shchuko/Automation-system/circuits/actuators_module/Схема модуля исполнителей.JPG

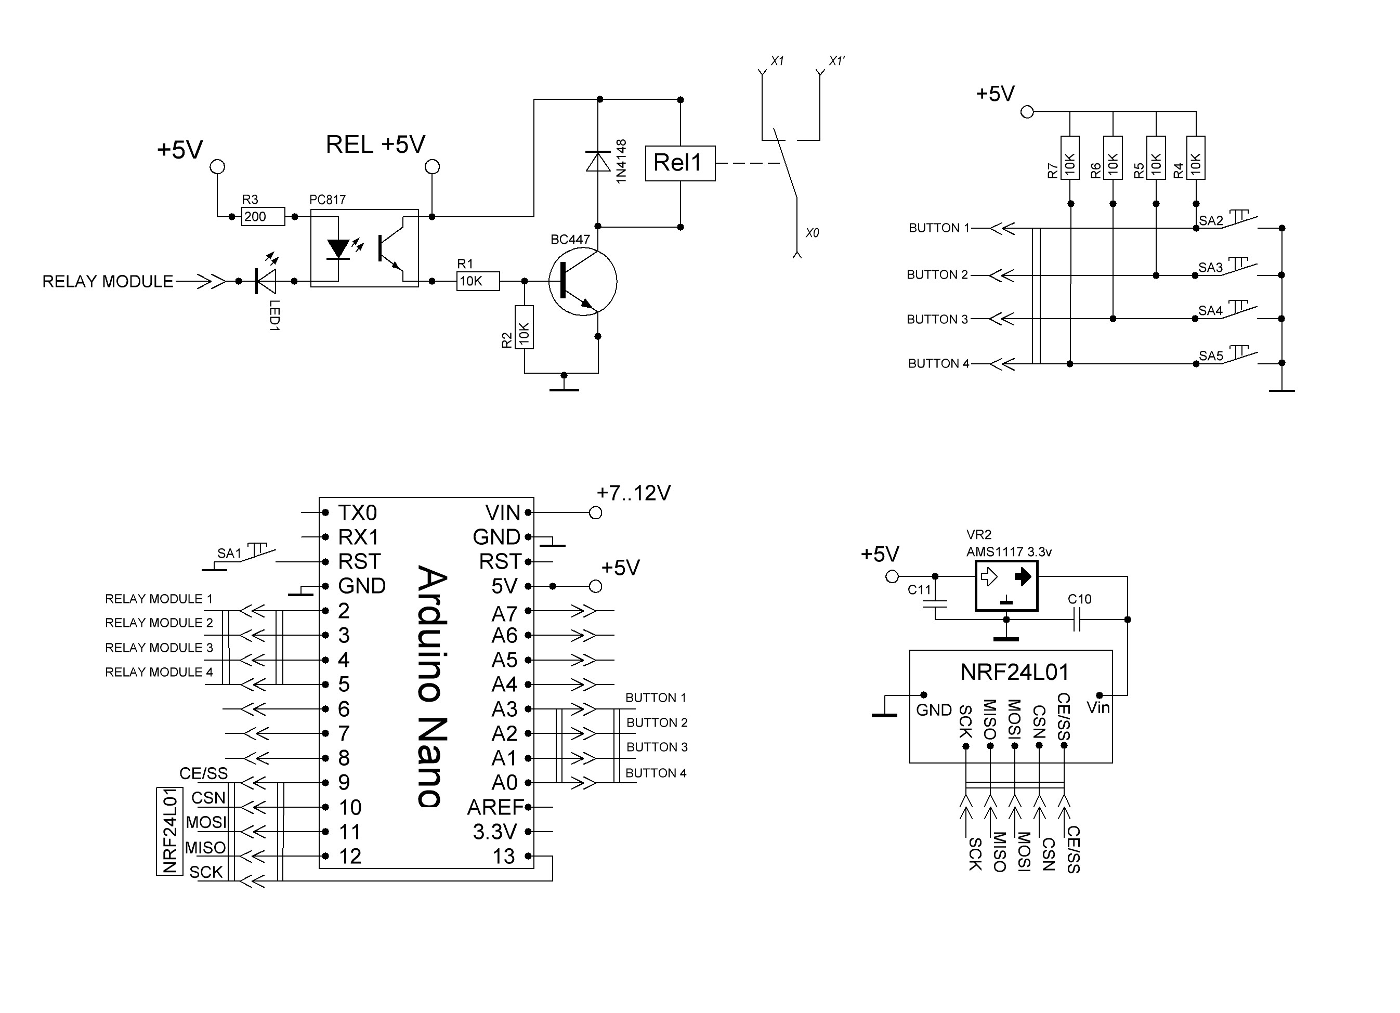
circuits/actuators_module/Схема модуля исполнителей.JPG
