shchuko/Automation-system/circuits/control_panel/Схема панели управления.JPG

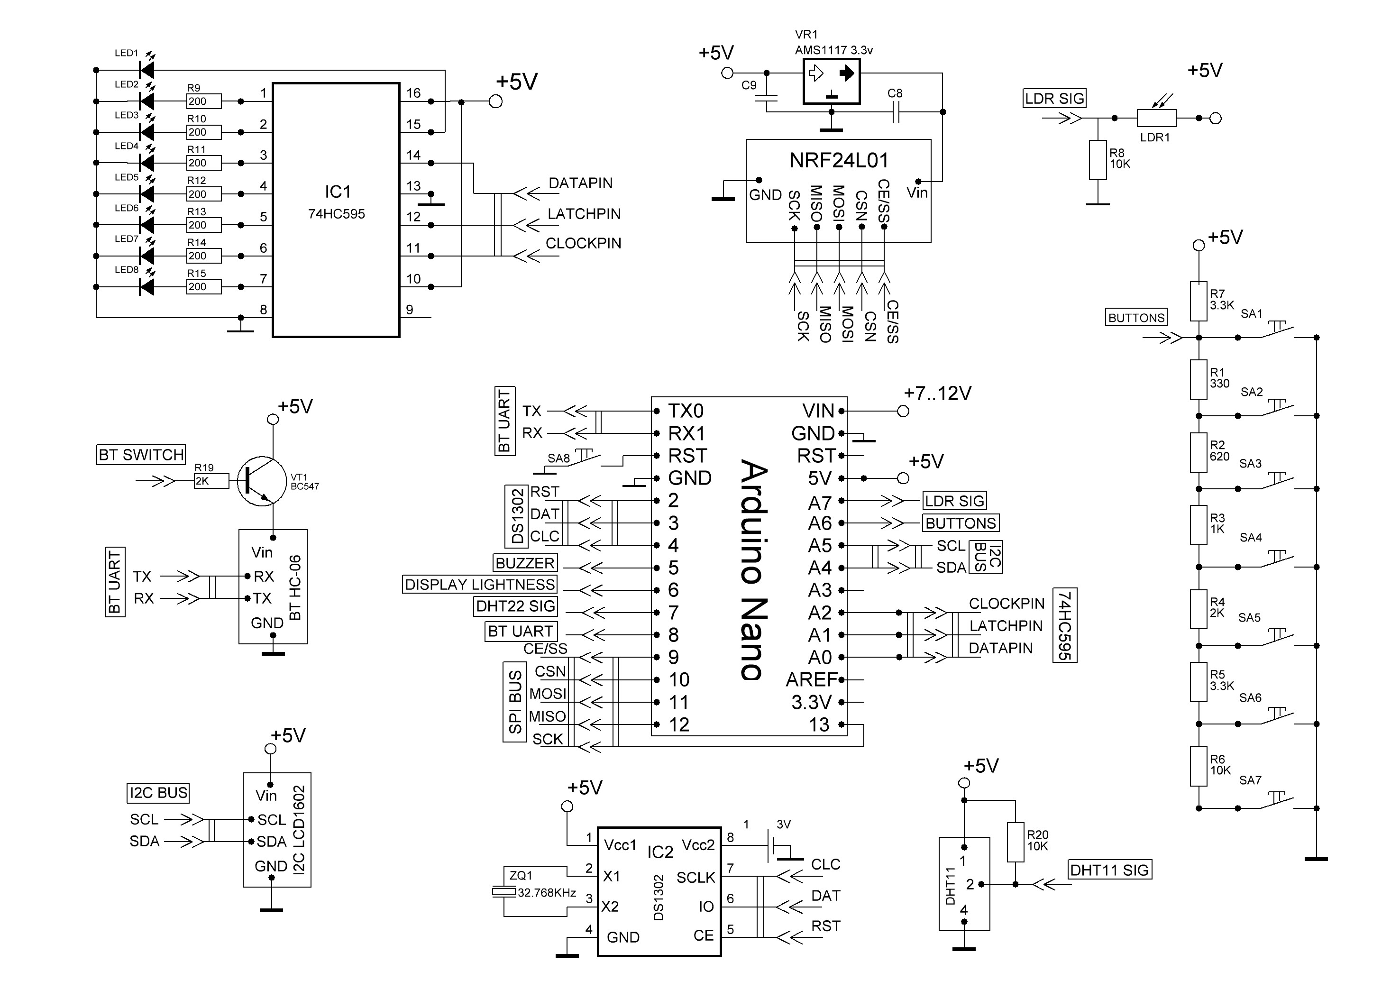
circuits/control_panel/Схема панели управления.JPG
