shchuko/Automation-system/circuits/main_controller/Схема центрального контроллера системы.JPG

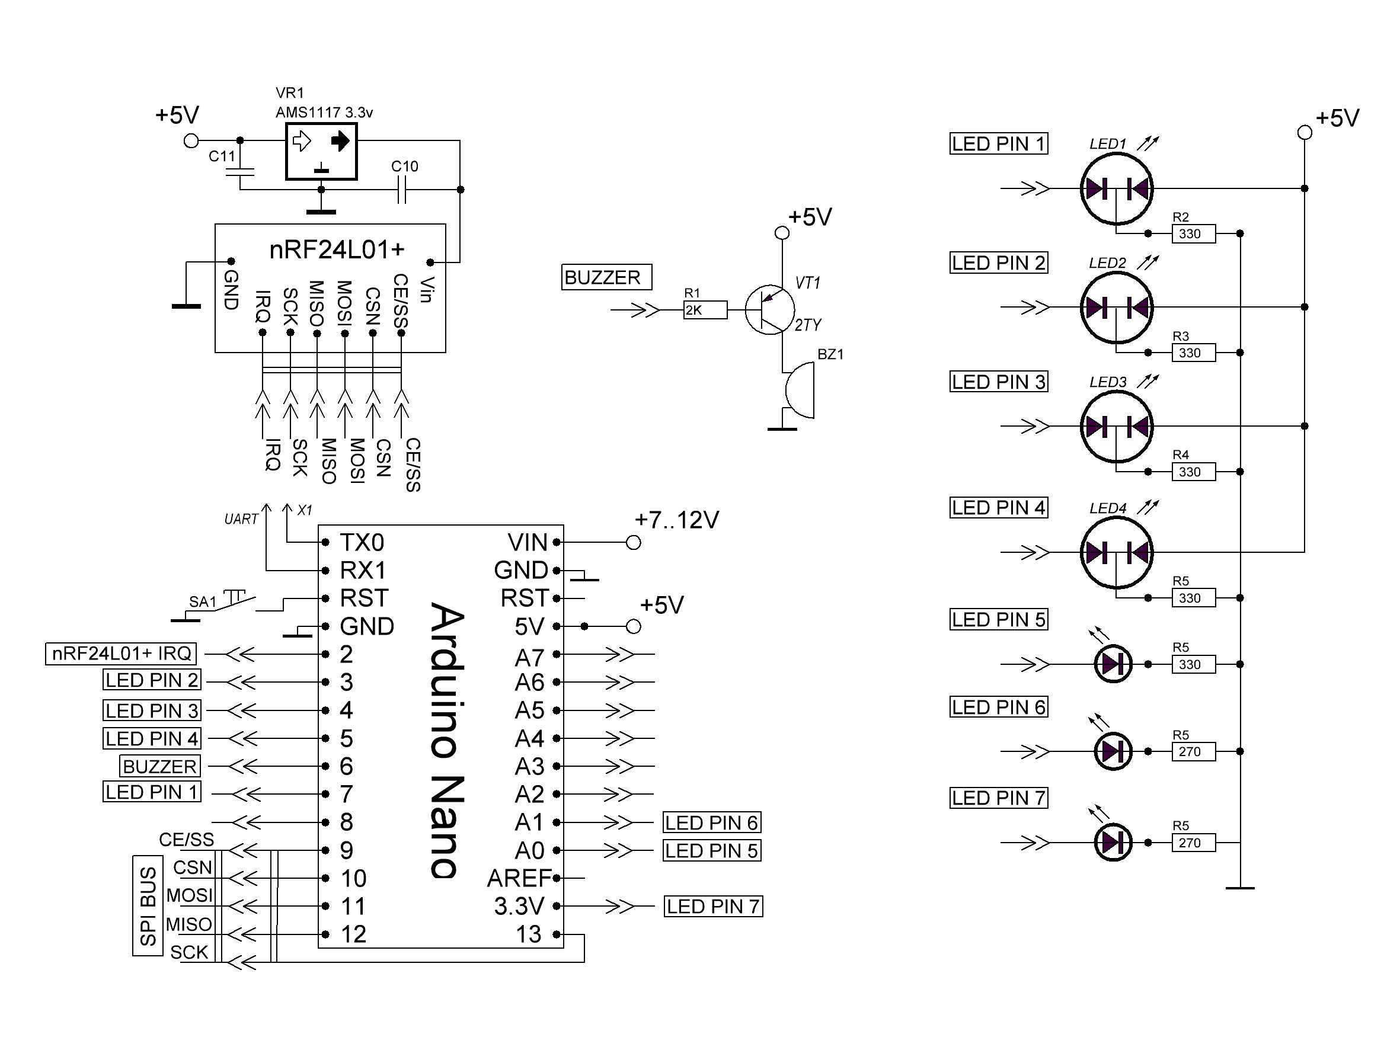
circuits/main_controller/Схема центрального контроллера системы.JPG
