shchuko/Automation-system/circuits/sensors_module/Панель сбора метеоданных.JPG

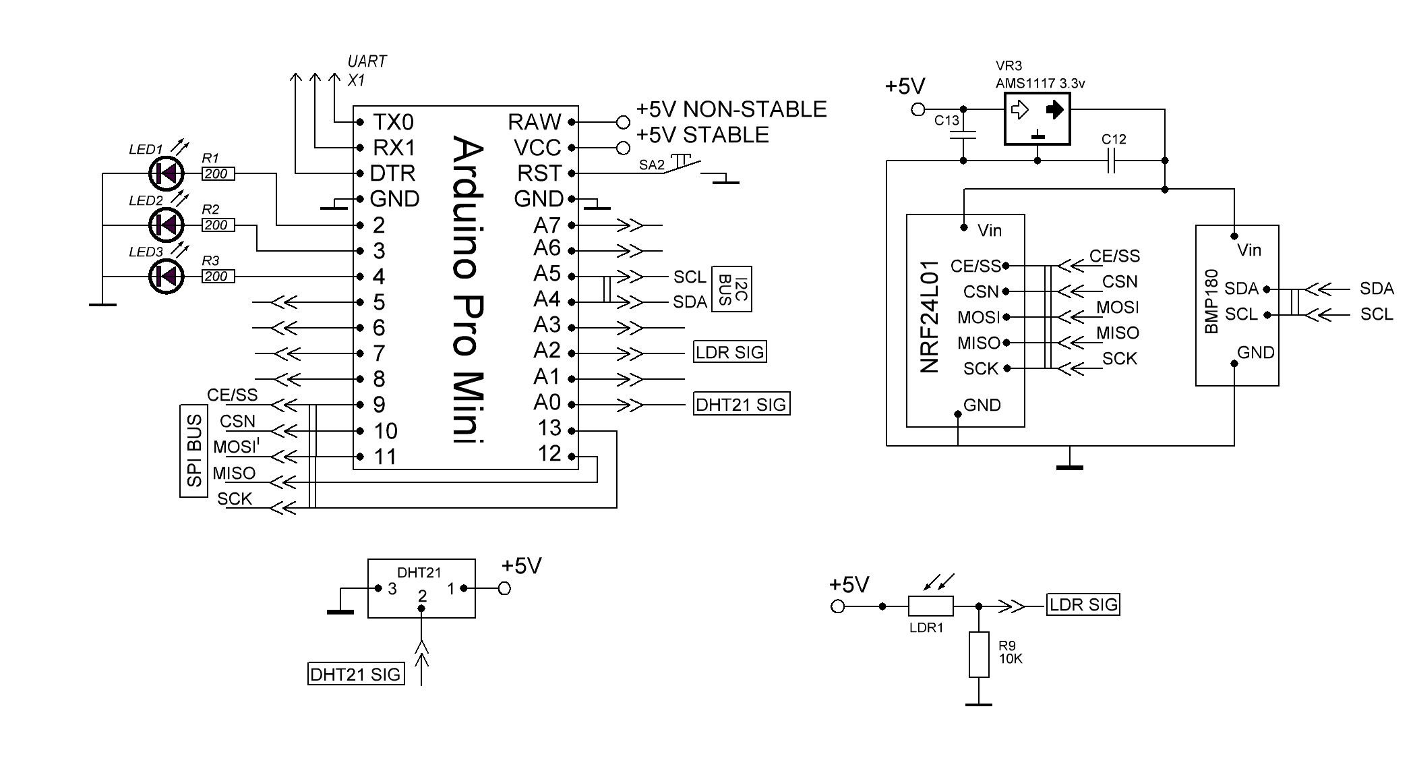
circuits/sensors_module/Панель сбора метеоданных.JPG
