shchuko/Automation-system/pcbs/actuators_module/Плата контроллера/Плата панели подключения электроприборов.JPG

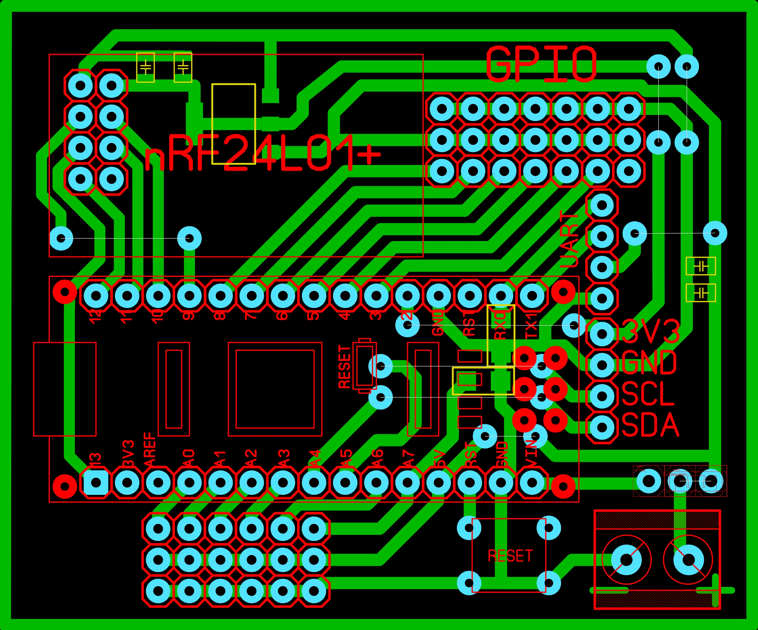
pcbs/actuators_module/Плата контроллера/Плата панели подключения электроприборов.JPG
