shchuko/Automation-system/pcbs/actuators_module/Плата модуля  реле/Плата реле.JPG

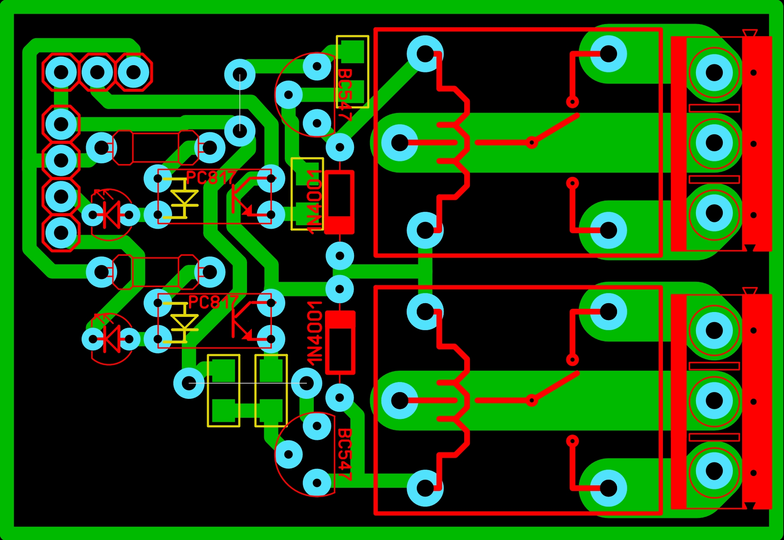
pcbs/actuators_module/Плата модуля реле/Плата реле.JPG
