shchuko/Automation-system/pcbs/main_controller/Печатная плата центрального контроллера.JPG

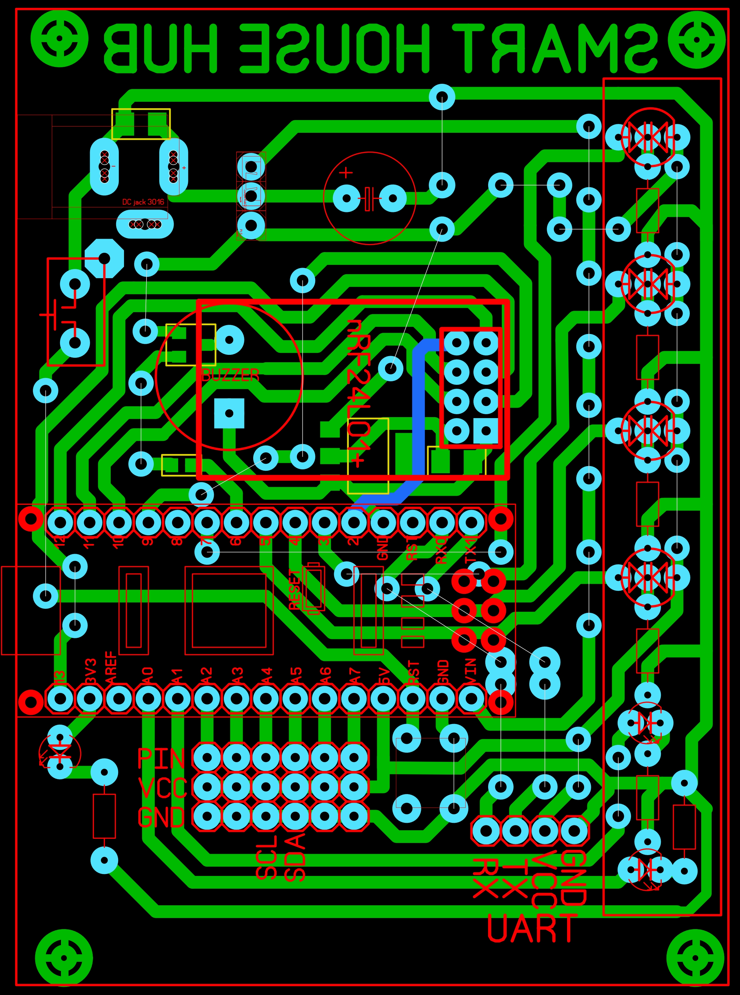
pcbs/main_controller/Печатная плата центрального контроллера.JPG
