shchuko/Automation-system/pcbs/sensors_module/Печатная плата модуля сбора метеоданных.JPG

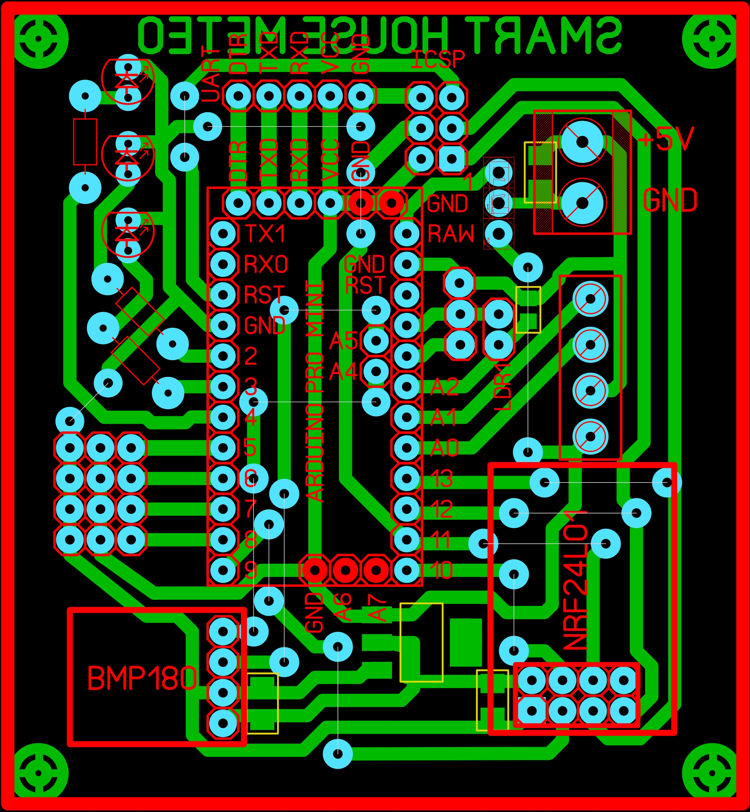
pcbs/sensors_module/Печатная плата модуля сбора метеоданных.JPG
