shchuko/Automation-system/(list of files, drawings)

Other design files:
circuits/actuators_module/Схема модуля исполнителей.spl7
circuits/control_panel/Схема панели управления.spl7
circuits/main_controller/Схема центрального контроллера системы.spl7
circuits/sensors_module/Панель сбора метеоданных.spl7
pcbs/actuators_module/Плата контроллера/Плата панели подключения электроприборов.lay6
pcbs/actuators_module/Плата модуля реле/Плата реле.lay6
pcbs/control_panel/Печатная плата панели управления.lay6
pcbs/main_controller/Печатная плата центрального контроллера.lay6
pcbs/sensors_module/Печатная плата модуля сбора метеоданных.lay6
