shchuko/Automation-system/(commit log)

2018-03-17 Baltic SEF version
    [Панель сбора метеоданных.spl7, Печатная плата модуля сбора метеоданных.lay6, Печатная плата панели управления.lay6, Печатная плата центрального контроллера.lay6, Плата панели подключения электроприборов.lay6, Плата реле.lay6, Схема модуля исполнителей.spl7, Схема панели управления.spl7]
2018-03-17 all files renamed correctly
    [Панель сбора метеоданных.spl7, Печатная плата модуля сбора метеоданных.lay6, Печатная плата панели управления.lay6, Печатная плата центрального контроллера.lay6, Плата панели подключения электроприборов.lay6, Плата реле.lay6, Схема модуля исполнителей.spl7, Схема панели управления.spl7]
